Dizzerin/Hover-Copter-Feedback-and-Control-System/Data/Hanging Pendulum Test - Trial 3.csv

Set 0 point | Enable Feedback Control | PWM Duty Cycle | R3 Voltage Drop (V) | Motor Current (Amps) | Theta (deg) | Theta Dot (rad/s) | Theta (deg) | Theta Dot (rad/s)
0 | 0 | 0 | 0 | 0 | 0.3240000009536743 | 0 | 0.3240000009536743 | 0
0 | 0 | 0 | 0 | 0 | 0.3240000009536743 | 0 | 0.3240000009536743 | 0
0 | 0 | 0 | 0 | 0 | 0.3240000009536743 | 0 | 0.3240000009536743 | 0
0 | 0 | 0 | 0 | 0 | 0.3240000009536743 | 0 | 0.3240000009536743 | 0
0 | 0 | 0 | 0 | 0 | 0.3240000009536743 | 0 | 0.3240000009536743 | 0
0 | 0 | 0 | 0 | 0 | 0.3240000009536743 | 0 | 0.3240000009536743 | 0
0 | 0 | 0 | 0 | 0 | 0.3240000009536743 | 0 | 0.3240000009536743 | 0
0 | 0 | 0 | 0 | 0 | 0.3240000009536743 | 0 | 0.3240000009536743 | 0
0 | 0 | 0 | 0 | 0 | 0.3240000009536743 | 0 | 0.3240000009536743 | 0
0 | 0 | 0 | 0 | 0 | 0.3240000009536743 | 0 | 0.3240000009536743 | 0
0 | 0 | 0 | 0 | 0 | 0.3240000009536743 | 0 | 0.3240000009536743 | 0
0 | 0 | 0 | 0 | 0 | 0.3240000009536743 | 0 | 0.3240000009536743 | 0
0 | 0 | 0 | 0 | 0 | 0.3240000009536743 | 0 | 0.3240000009536743 | 0
0 | 0 | 0 | 0 | 0 | 0.3240000009536743 | 0 | 0.3240000009536743 | 0
0 | 0 | 0 | 0 | 0 | 0.3240000009536743 | 0 | 0.3240000009536743 | 0
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
