Dizzerin/Hover-Copter-Feedback-and-Control-System/Data/Hanging Pendulum Test - Trial 4.csv

Set 0 point | Enable Feedback Control | PWM Duty Cycle | R3 Voltage Drop (V) | Motor Current (Amps) | Theta (deg) | Theta Dot (rad/s) | Theta (deg) | Theta Dot (rad/s)
NaN | 0 | 0 | 0 | 0 | 89.24400329589844 | -0.0001256704272236675 | 89.24400329589844 | -0.0001256704272236675
NaN | 0 | 0 | 0 | 0 | 89.96399688720703 | -0.000251340854447335 | 89.96399688720703 | -0.000251340854447335
NaN | 0 | 0 | 0 | 0 | 90.21600341796875 | 0.0001256704272236675 | 90.21600341796875 | 0.0001256704272236675
NaN | 0 | 0 | 0 | 0 | 89.71199798583984 | 0.00025131701841019094 | 89.71199798583984 | 0.00025131701841019094
NaN | 0 | 0 | 0 | 0 | 88.95600128173828 | 0.00025131701841019094 | 88.95600128173828 | 0.00025131701841019094
NaN | 0 | 0 | 0 | 0 | 88.7760009765625 | -0.00012564659118652344 | 88.7760009765625 | -0.00012564659118652344
NaN | 0 | 0 | 0 | 0 | 89.06400299072266 | -0.0001256704272236675 | 89.06400299072266 | -0.0001256704272236675
NaN | 0 | 0 | 0 | 0 | 89.27999877929688 | 0 | 89.27999877929688 | 0
NaN | 0 | 0 | 0 | 0 | 89.1719970703125 | 0 | 89.1719970703125 | 0
NaN | 0 | 0 | 0 | 0 | 88.95600128173828 | 0 | 88.95600128173828 | 0
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
