Dizzerin/Hover-Copter-Feedback-and-Control-System/Data/Hanging Pendulum Tests - Complied.xlsx

Sheet: Hanging Pendulum Test - Trial 4
Sample | Time (us) | Time (s) | Theta (deg) | Theta (rad)
0 | 0 | 0 | 89.09999847 | 1.555088337 | Time between Reports | 50000 | us | Period | 0.88 | s
1 | 50000 | 0.05 | 89.06400299 | 1.554460097 | Conversion to seconds | 1e-06 | s/us | Frequency | 1.136363636 | Hz
2 | 100000 | 0.1 | 88.81200409 | 1.550061887
3 | 150000 | 0.15 | 86.50800323 | 1.509849486
4 | 200000 | 0.2 | 80.27999878 | 1.401150302 |  |  |  |  |  |  | Friction looks like it dies off exponentially
5 | 250000 | 0.25 | 70.23600006 | 1.225849454 |  |  |  |  |  |  | Drag
6 | 300000 | 0.3 | 56.55599976 | 0.9870884076 |  |  |  |  |  |  | Static Friction
7 | 350000 | 0.35 | 39.81600189 | 0.694920328 |  |  |  |  |  |  | Kinnetic Friction
8 | 400000 | 0.4 | 20.91600037 | 0.3650530728 |  |  |  |  |  |  | Damping
9 | 450000 | 0.45 | 0.936000049 | 0.01633628265
10 | 500000 | 0.5 | -18.64799881 | -0.3254689781 |  |  |  |  |  |  | Friction:
11 | 550000 | 0.55 | -36.61199951 | -0.6389999372 |  |  |  |  |  |  | -Beta*Omega
12 | 600000 | 0.6 | -51.84000015 | -0.9047786869 |  |  |  |  |  |  | guess or solve for beta to get exponential decay that matches our results
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
