Dizzerin/Hover-Copter-Feedback-and-Control-System/PCB Files (KiCad)/Hover Copters.pdf

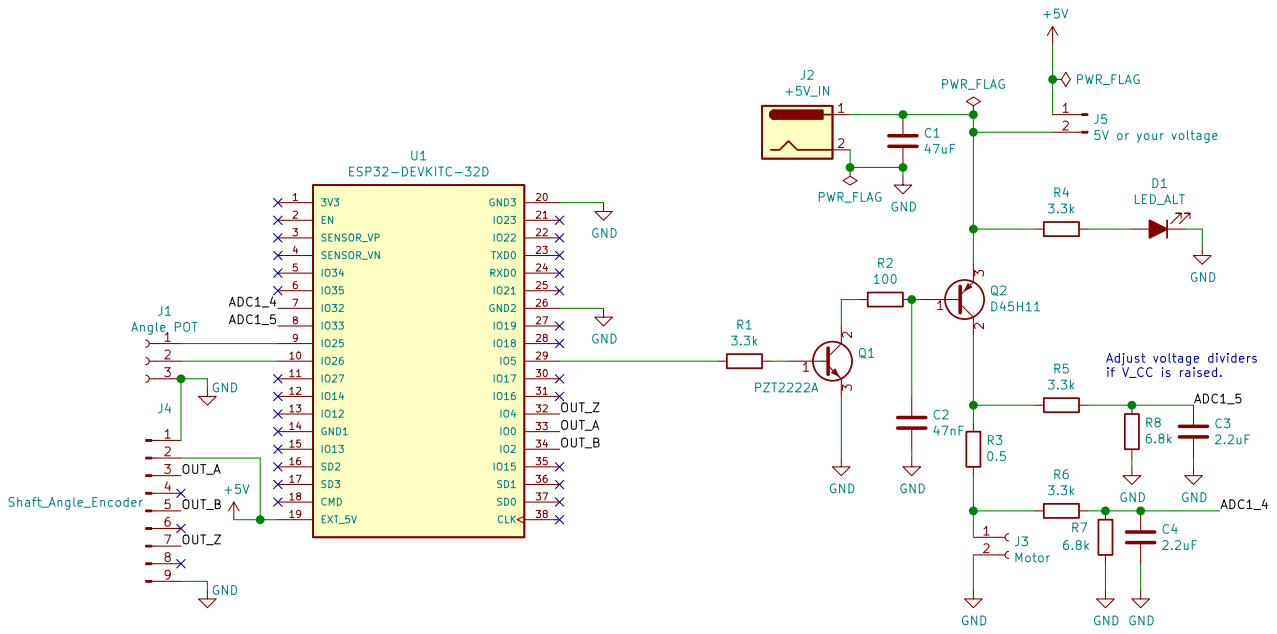
[picture p3: page 1]

5V or your voltage GND GND GND

File: Hover Copters.sch Sheet: / WWU

Id: 1/1 Title: Hover Copter
