Dizzerin/Hover-Copter-Feedback-and-Control-System/6302view Software/6302view/examples/slider_toggle/slider_toggle.ino

#include <Six302.h>

/* For this demo, make sure to have the `#define S302_SERIAL`
   macro enabled in the library. 

   This demo presents a slider that alternates between -1
   and +1 */

// microseconds
#define STEP_TIME 100000
#define REPORT_TIME 500000

CommManager cm(STEP_TIME, REPORT_TIME);

float input;
float output;

void setup() {
   
   /* Add modules */
   input = 3.0;
   cm.addPlot(&output, "Right", -1.1, +1.1);
   cm.addSlider(&input, "Left",   -1,   +1, 0.1, true); // true indicates toggle
   

   /* Ready to communicate over Serial */
   cm.connect(&Serial, 115200);
}

void loop() {
   output = input;
   cm.step();
}
