Dizzerin/Hover-Copter-Feedback-and-Control-System/6302view Software/6302view/examples/square/Serial/Serial.ino

/* For this demo, make sure the `#define S302_SERIAL` macro
   is chosen in the library. This demo should compile on the Teensy,
   ESP32, and ESP8266. */

#include <Six302.h>

// microseconds
#define STEP_TIME 10000
#define REPORT_TIME 50000

CommManager cm(STEP_TIME, REPORT_TIME);

float input;
float output;

void setup() {
   /* Add modules */
   input = 3.0;
   cm.addSlider(&input, "Input", -5, 5, 0.1);
   cm.addPlot(&output, "Output", -1, 30);

   /* Ready to communicate over serial */
   cm.connect(&Serial, 115200);
}

void loop() {
   output = input * input;
   cm.step();
}
