Dizzerin/Hover-Copter-Feedback-and-Control-System/(commit log)

2021-04-27 Added PCB Files, Updated .gitignore
    [Hover Copters.kicad_pcb, Hover Copters.sch]
2021-05-03 Updated pins (since we switched what pins were were using) and added basic test software which doesn't use 6302view
    [Initial_Hardware_Test_6302view.ino, Initial_Hardware_Test_no_6302view.ino]
2021-05-05 Added support for reading ADC pins and reporting motor current. Cleaned up some of the code as well
2021-05-06 Added running averages and graphs for high and low voltage values
2021-05-08 Increased PWM frequency and reduced running average samples, also flipped encoder graph to consider counterclock wise positive since that is clockwise the way we usually look at it
    [Initial_Hardware_Test_6302view.ino]
2021-05-08 Tweeked some parameters in the code, recorded some data of PWM vs motor voltage and current
    [Temp Data.xlsx]
2021-05-09 Removed temporary data file
    [Temp Data.xlsx]
2021-05-10 Renamed folder and file. Added Motor and Thtrust Data
    [Motor and Thrust Data.xlsx]
2021-05-11 Added hanging pendulum data. Revised hover copter controller.
    [Hanging Pendulum Test - Trial 1.csv, Hanging Pendulum Test - Trial 2.csv, Hanging Pendulum Test - Trial 3.csv, Hanging Pendulum Test - Trial 4.csv]
2021-05-11 Complied hanging down test results into one file and generated graphs for them
    [Hanging Pendulum Tests - Complied.xlsx]
2021-05-11 Corrected bug realizing STEP_TIME was in microseconds instead of miliseconds
    [Hover_Copter_Controller.ino]
2021-05-11 Created state space model for hover arm hanging down acting as a pendulum.
    [Hanging Pendulum Tests - Complied.xlsx]
2021-05-13 Added new system model, manually placed poles, LQR pole placement, and updated controller program.
    [Hanging Pendulum Tests - Complied.xlsx]
2021-05-14 Bug fixes in controller, and more tweaking with pole placement
    [Hover_Copter_Controller.ino]
2021-05-18 Updated small signal PWM conversion (removed division by 100)
2021-05-22 Impleted max PWM limit and changed k gains to matrix
